sigma0us/radar-synth/README.md

# radar-synth
Dual PLL radar transmitter, design for prototyping
