sigma0us/radar-synth/hardware/output/lmx2572evm-ass/radar-synth-B_Fab.pdf

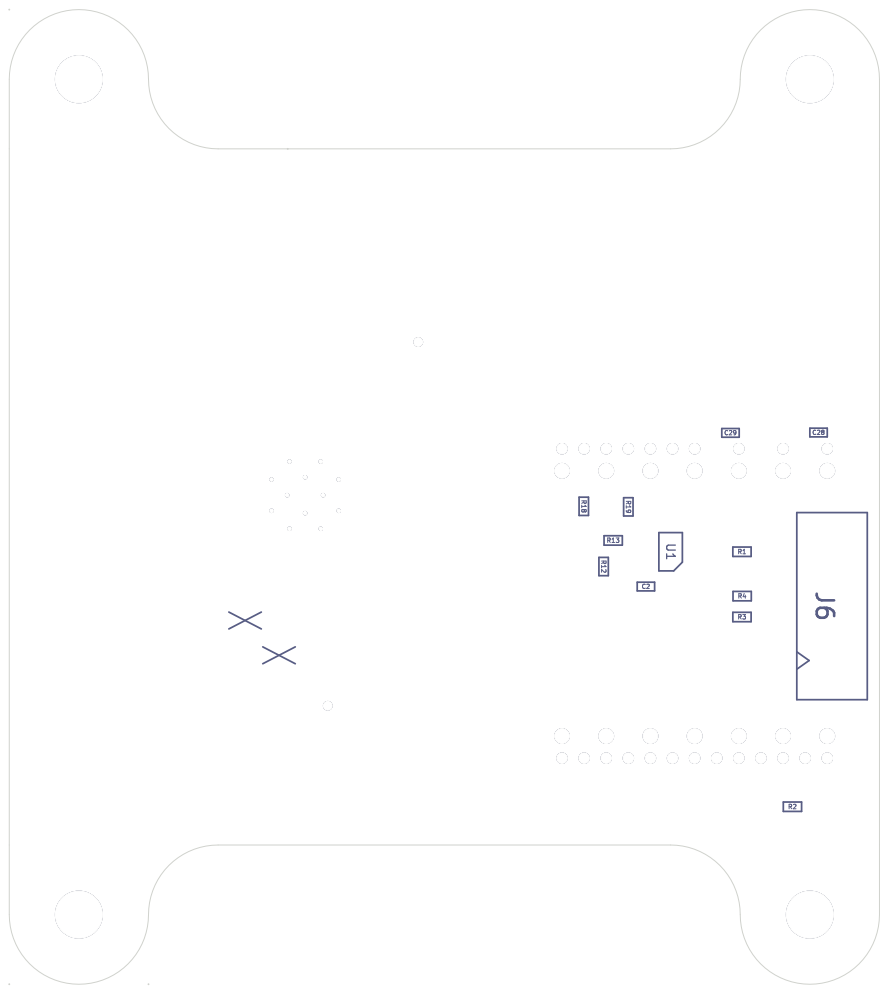
[picture p1: page 1]

Id: 1/1 Title: File: radar-synth.kicad_pcb Sheet:
