sigma0us/radar-synth/hardware/output/lmx2572evm-ass/radar-synth-F_Fab.pdf

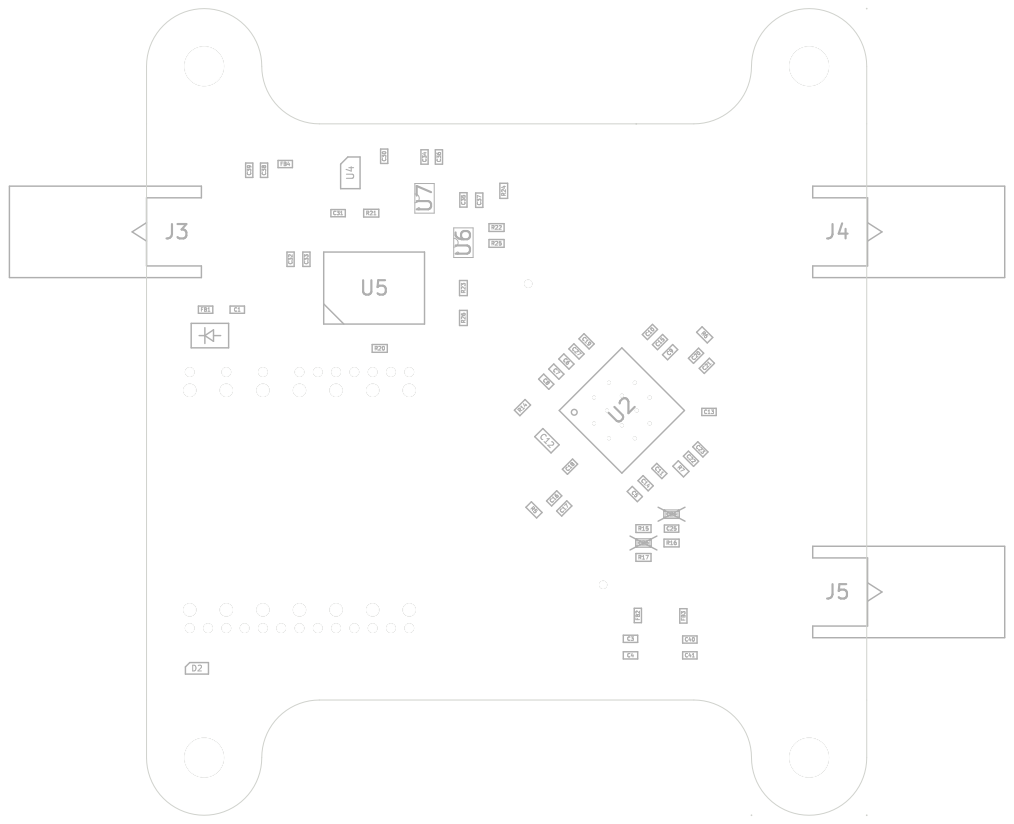
[picture p2: page 1]
