sigma0us/radar-synth/hardware/radar-synth.kicad_pcb

## KiCad design hardware/radar-synth.kicad_pcb (2025-03-31)

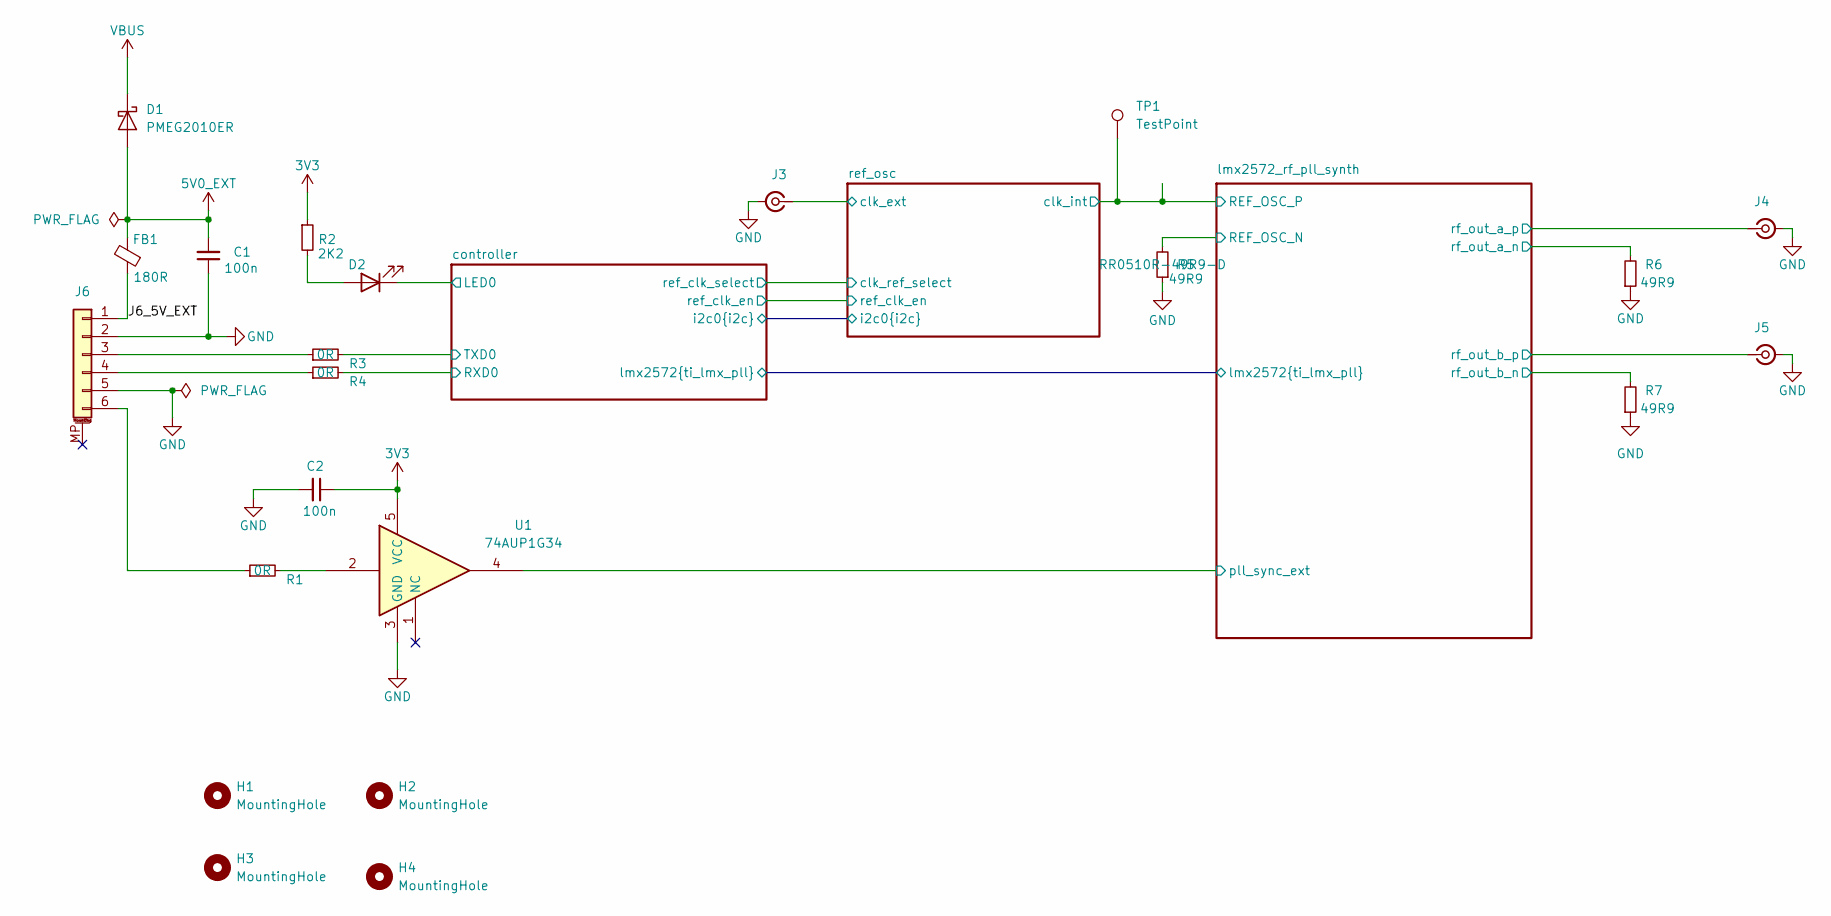
[picture p3: schematic radar-synth.kicad_sch, TOP LEVEL]

Parts:
C1, C2: 100n; C_0402_1005Metric; Voltage 25V; Tolerance 10%; MPN CL05B104KA5NNNC
D1: PMEG2010ER; Nexperia_CFP3_SOD-123W; MPN PMEG2010ER,115
D2: LED; LED_0603_1608Metric; MPN 150060SS75000
FB1: 180R; L_0402_1005Metric; MPN BLM15PX181SZ1D
H1, H2, H3, H4: MountingHole; MountingHole_2.7mm_M2.5
J3, J4, J5: Conn_Coaxial_Small; SMA_Samtec_SMA-J-P-H-ST-EM1_EdgeMount; MPN SMA-J-P-H-ST-EM1
J6: Conn_01x06_MountingPin; JST_GH_SM06B-GHS-TB_1x06-1MP_P1.25mm_Horizontal; MPN SM06B-GHS-TB
R1, R3, R4: 0R; R_0402_1005Metric; MPN ERJ-2GE0R00X
R2: 2K2; R_0402_1005Metric; MPN ERA-2AED222X
R5: 49R9; R_0402_1005Metric; Tolerance 5%; MPN RR0510R-49R9-D
R6, R7: 49R9; R_0402_1005Metric; MPN RR0510R-49R9-D
TP1: TestPoint; TestPoint_THTPad_1.0x1.0mm_Drill0.5mm
U1: 74AUP1G34; SOT-353_SC-70-5; MPN 74AUP1G34SE-7

Connections:
3V3: C2.1, R2.1, U1.5 (VCC); also elsewhere on the board
5V0_EXT: C1.2, D1.2 (A), FB1.2
/J6_5V_EXT: FB1.1, J6.1
/controller/LED0: D2.1 (K); also elsewhere on the board
/controller/RXD0: R4.2; also elsewhere on the board
/controller/TXD0: R3.2; also elsewhere on the board
/lmx2572_rf_pll_synth/REF_OSC_N: R5.2; also elsewhere on the board
/lmx2572_rf_pll_synth/REF_OSC_P: TP1.1; also elsewhere on the board
/lmx2572_rf_pll_synth/pll_sync_ext: U1.4; also elsewhere on the board
/lmx2572_rf_pll_synth/rf_out_a_n: R6.2; also elsewhere on the board
/lmx2572_rf_pll_synth/rf_out_a_p: J4.1 (In); also elsewhere on the board
/lmx2572_rf_pll_synth/rf_out_b_n: R7.2; also elsewhere on the board
/lmx2572_rf_pll_synth/rf_out_b_p: J5.1 (In); also elsewhere on the board
/ref_osc/clk_ext: J3.1 (In); also elsewhere on the board
GND: C1.1, C2.2, J3.2 (Ext), J4.2 (Ext), J5.2 (Ext), J6.2, J6.5, R5.1, R6.1, R7.1, U1.3 (GND); also elsewhere on the board
unnamed: D2.2 (A), R2.2
unnamed: J6.3, R3.1
unnamed: J6.4, R4.1
unnamed: J6.6, R1.1
unnamed: R1.2, U1.2
VBUS: D1.1 (K); also elsewhere on the board

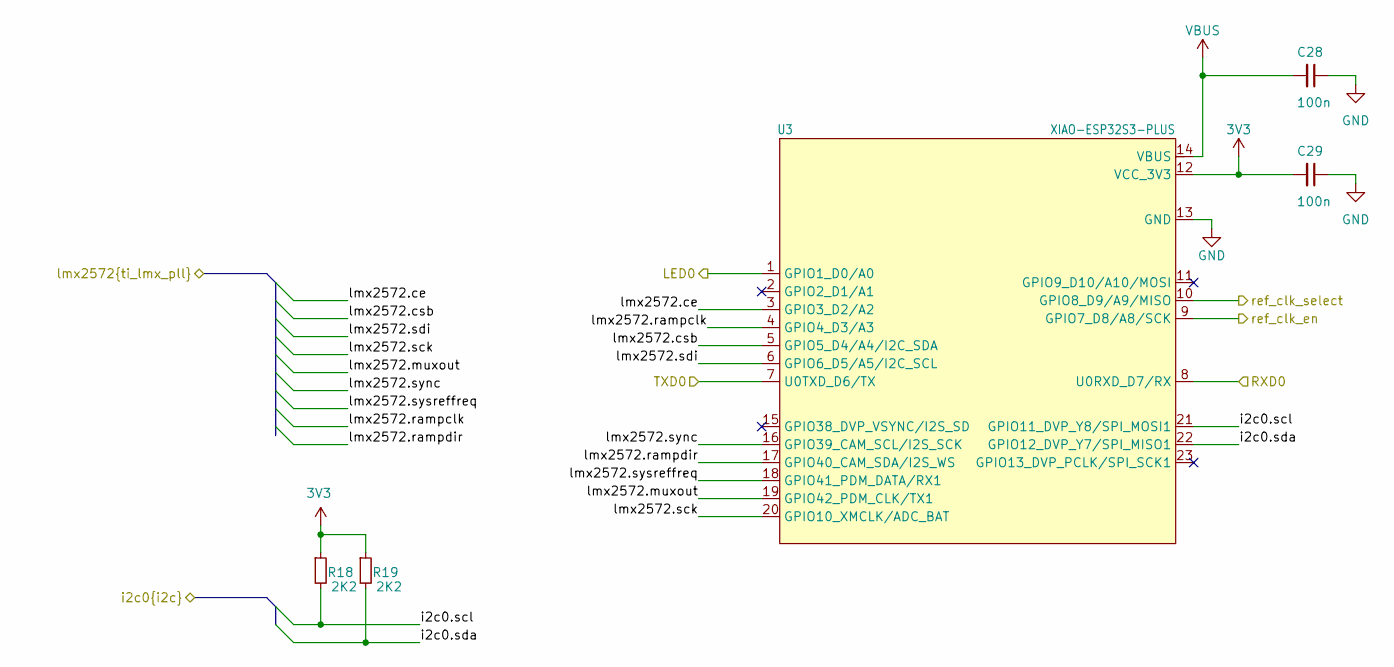
[picture p4: schematic xia0_esp32s3p_controller.kicad_sch, ESP32S3 PLUS MICROCONTROLLER]

Parts:
C28, C29: 100n; C_0402_1005Metric; Voltage 25V; Tolerance 10%; MPN CL05B104KA5NNNC
R18, R19: 2K2; R_0402_1005Metric; MPN ERA-2AED222X
U3: XIAO-ESP32S3-PLUS; XIAO-ESP32S3P-SMD-2.54-21X17.8MM; MPN 113991114

Connections:
3V3: C29.2, R18.1, R19.1, U3.12 (VCC_3V3); also elsewhere on the board
/controller/LED0: U3.1 (GPIO1_D0/A0); also elsewhere on the board
/controller/RXD0: U3.8 (U0RXD_D7/RX); also elsewhere on the board
/controller/TXD0: U3.7 (U0TXD_D6/TX); also elsewhere on the board
/controller/i2c0.scl: R18.2, U3.21 (GPIO11_DVP_Y8/SPI_MOSI1); also elsewhere on the board
/controller/i2c0.sda: R19.2, U3.22 (GPIO12_DVP_Y7/SPI_MISO1); also elsewhere on the board
/controller/lmx2572.ce: U3.3 (GPIO3_D2/A2); also elsewhere on the board
/controller/lmx2572.csb: U3.5 (GPIO5_D4/A4/I2C_SDA); also elsewhere on the board
/controller/lmx2572.muxout: U3.19 (GPIO42_PDM_CLK/TX1); also elsewhere on the board
/controller/lmx2572.rampclk: U3.4 (GPIO4_D3/A3); also elsewhere on the board
/controller/lmx2572.rampdir: U3.17 (GPIO40_CAM_SDA/I2S_WS); also elsewhere on the board
/controller/lmx2572.sck: U3.20 (GPIO10_XMCLK/ADC_BAT); also elsewhere on the board
/controller/lmx2572.sdi: U3.6 (GPIO6_D5/A5/I2C_SCL); also elsewhere on the board
/controller/lmx2572.sync: U3.16 (GPIO39_CAM_SCL/I2S_SCK); also elsewhere on the board
/controller/lmx2572.sysreffreq: U3.18 (GPIO41_PDM_DATA/RX1); also elsewhere on the board
/controller/ref_clk_en: U3.9 (GPIO7_D8/A8/SCK); also elsewhere on the board
/controller/ref_clk_select: U3.10 (GPIO8_D9/A9/MISO); also elsewhere on the board
GND: C28.1, C29.1, U3.13 (GND); also elsewhere on the board
VBUS: C28.2, U3.14 (VBUS); also elsewhere on the board

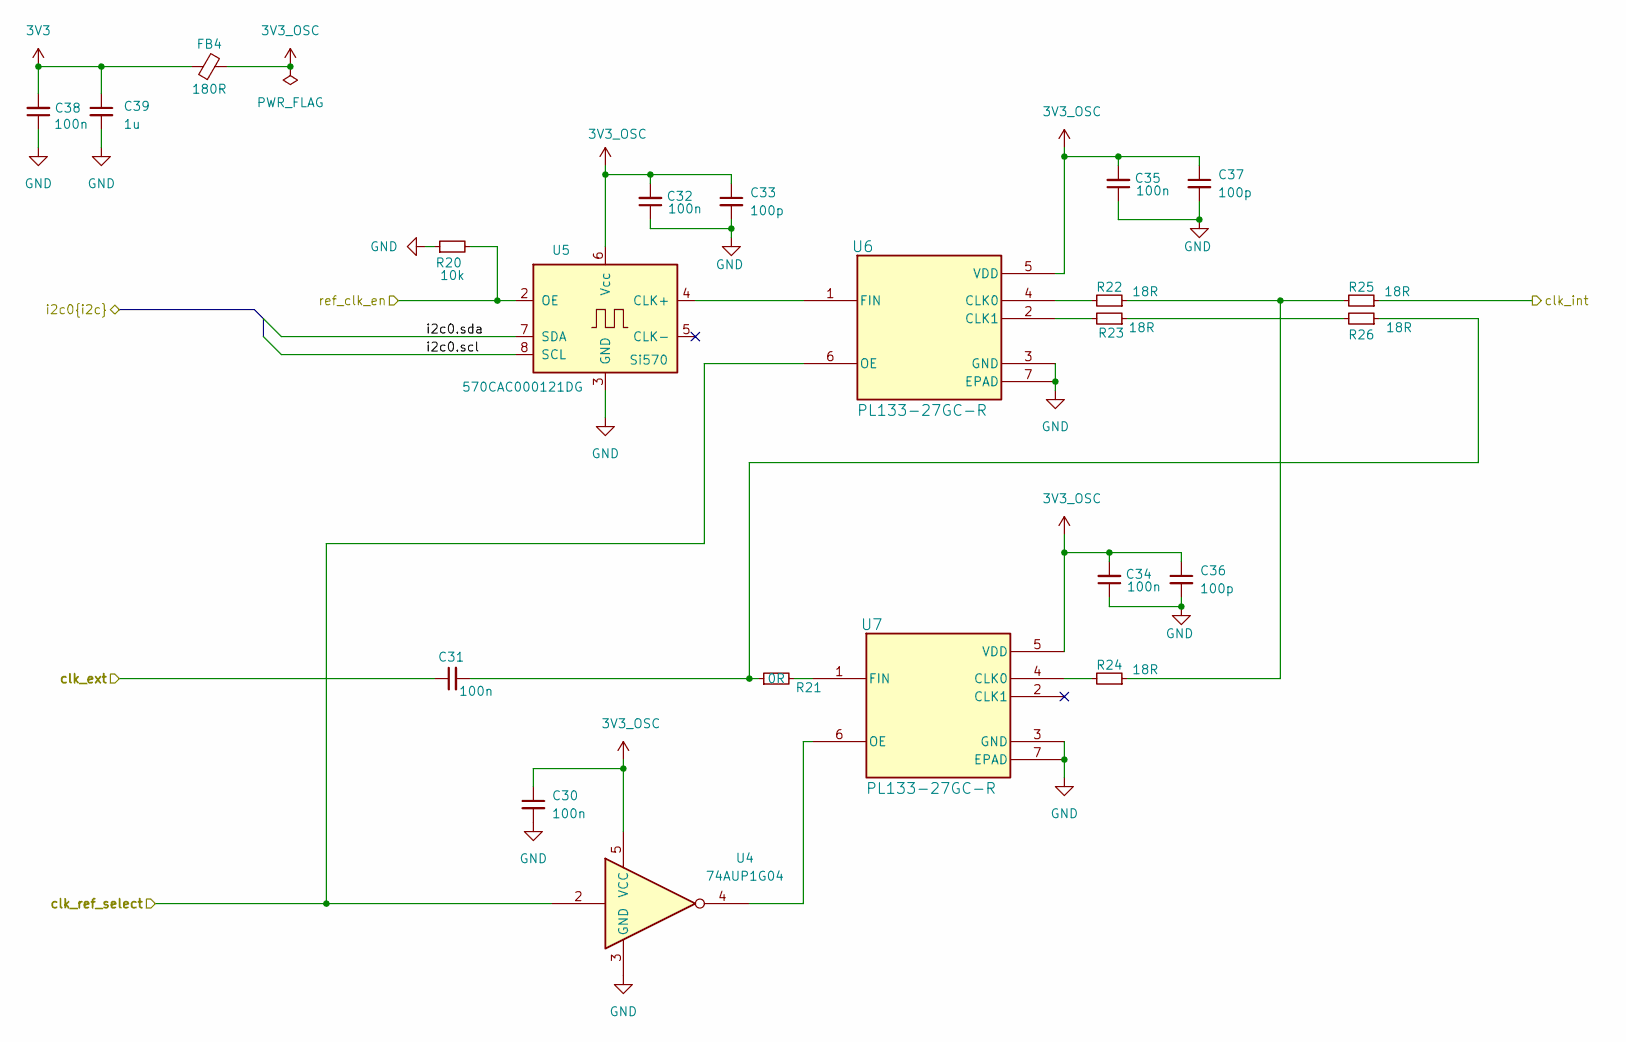
[picture p5: schematic reference_clock.kicad_sch, REFERENCE OSCILLATOR]

Parts:
C30: 100n; C_0402_1005Metric; MPN CL05B104KA5NNNC
C31, C32, C34, C35, C38: 100n; C_0402_1005Metric; Voltage 25V; Tolerance 10%; MPN CL05B104KA5NNNC
C33, C36, C37: 100p; C_0402_1005Metric; MPN KGM05AR71H101KN
C39: 1u; C_0402_1005Metric; Voltage 16V; Tolerance 10%; MPN EMK105BJ105KV-F
FB4: 180R; L_0402_1005Metric; MPN BLM15PX181SZ1D
R20: 10k; R_0402_1005Metric; MPN RC0402JR-0710KL
R21: 0R; R_0402_1005Metric; MPN ERJ-2GE0R00X
R22, R23, R24, R25, R26: 18R; R_0402_1005Metric; MPN CR0402-FX-18R0GLF
U4: 74AUP1G04; SOT-353_SC-70-5; MPN SN74AUP1G04DCKR
U5: Si570; Oscillator_SMD_SI570_SI571_Standard; MPN 570CAC000121DG
U6, U7: PL133-27GC-R; TDFN2013-6LD-PL-1_MCH; MPN PL133-27GC-R

Connections:
3V3: C38.2, C39.1, FB4.1; also elsewhere on the board
3V3_OSC: C30.1, C32.2, C33.1, C34.2, C35.2, C36.1, C37.1, FB4.2, U4.5 (VCC), U5.6 (Vcc), U6.5 (VDD), U7.5 (VDD)
/controller/i2c0.scl: U5.8 (SCL); also elsewhere on the board
/controller/i2c0.sda: U5.7 (SDA); also elsewhere on the board
/controller/ref_clk_en: R20.2, U5.2 (OE); also elsewhere on the board
/controller/ref_clk_select: U4.2, U6.6 (OE); also elsewhere on the board
/lmx2572_rf_pll_synth/REF_OSC_P: R25.1; also elsewhere on the board
/ref_osc/clk_ext: C31.1; also elsewhere on the board
GND: C30.2, C32.1, C33.2, C34.1, C35.1, C36.2, C37.2, C38.1, C39.2, R20.1, U4.3 (GND), U5.3 (GND), U6.3 (GND), U6.7 (EPAD), U7.3 (GND), U7.7 (EPAD); also elsewhere on the board
unnamed: C31.2, R21.1, R26.1
unnamed: R22.1, R24.1, R25.2
unnamed: R23.1, R26.2
unnamed: U5.4 (CLK+), U6.1 (FIN)
unnamed: R22.2, U6.4 (CLK0)
unnamed: R23.2, U6.2 (CLK1)
unnamed: R24.2, U7.4 (CLK0)
unnamed: R21.2, U7.1 (FIN)
unnamed: U4.4, U7.6 (OE)

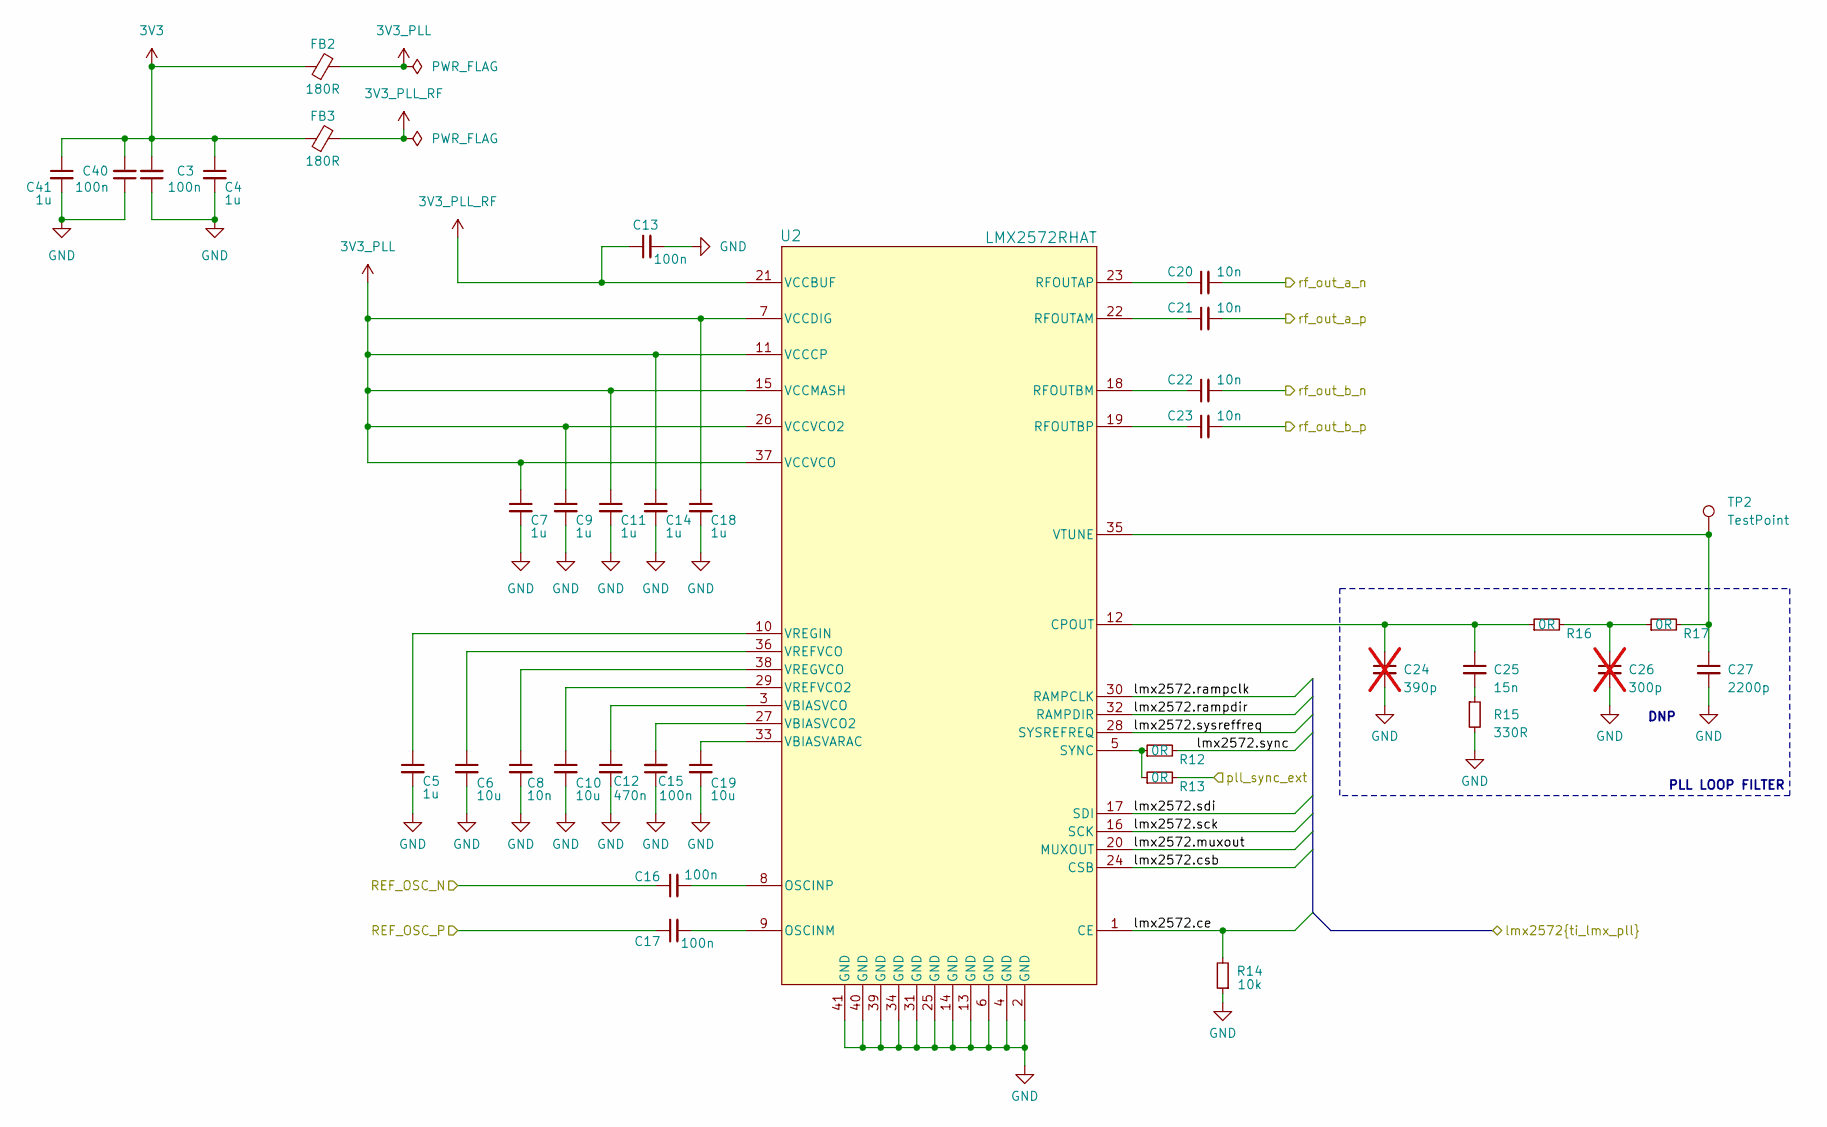
[picture p6: schematic lmx2572_rf_pll.kicad_sch, LMX2572 RF SYNTHESIZER]

Parts:
C3, C13, C15, C16, C17, C40: 100n; C_0402_1005Metric; Voltage 25V; Tolerance 10%; MPN CL05B104KA5NNNC
C4, C5, C7, C9, C11, C14, C18, C41: 1u; C_0402_1005Metric; Voltage 16V; Tolerance 10%; MPN EMK105BJ105KV-F
C6, C10, C19: 10u; C_0402_1005Metric; Voltage 10v; Tolerance 20%; MPN GRM155R61A106ME11D
C8, C20, C21, C22, C23: 10n; C_0402_1005Metric; Voltage 16V; Tolerance 10%; MPN 520L103KT16T
C12: 470n; C_0603_1608Metric; Voltage 25V; Tolerance 10%; MPN MBAST168SB7474KTNA18
C24: 390p; C_0402_1005Metric; MPN GRM1555C1H391JA01D; not fitted
C25: 15n; C_0402_1005Metric; MPN C0402C153J4RACTU
C26: 300p; C_0402_1005Metric; MPN GRM1555C1H301JA01D; not fitted
C27: 2200p; C_0402_1005Metric; MPN VJ0402Y222JXXAC
FB2, FB3: 180R; L_0402_1005Metric; MPN BLM15PX181SZ1D
R12, R13, R16, R17: 0R; R_0402_1005Metric; MPN ERJ-2GE0R00X
R14: 10k; R_0402_1005Metric; MPN RC0402JR-0710KL
R15: 330R; R_0402_1005Metric; MPN RC0402JR-07330RL
TP2: TestPoint; TestPoint_THTPad_1.0x1.0mm_Drill0.5mm
U2: LMX2572RHAT; RHA0040H; MPN LMX2572RHAT

Connections:
3V3: C3.2, C4.1, C40.2, C41.1, FB2.1, FB3.1; also elsewhere on the board
3V3_PLL: C7.1, C9.1, C11.1, C14.1, C18.1, FB2.2, U2.7 (VCCDIG), U2.11 (VCCCP), U2.15 (VCCMASH), U2.26 (VCCVCO2), U2.37 (VCCVCO)
3V3_PLL_RF: C13.1, FB3.2, U2.21 (VCCBUF)
/controller/lmx2572.ce: R14.2, U2.1 (CE); also elsewhere on the board
/controller/lmx2572.csb: U2.24 (CSB); also elsewhere on the board
/controller/lmx2572.muxout: U2.20 (MUXOUT); also elsewhere on the board
/controller/lmx2572.rampclk: U2.30 (RAMPCLK); also elsewhere on the board
/controller/lmx2572.rampdir: U2.32 (RAMPDIR); also elsewhere on the board
/controller/lmx2572.sck: U2.16 (SCK); also elsewhere on the board
/controller/lmx2572.sdi: U2.17 (SDI); also elsewhere on the board
/controller/lmx2572.sync: R12.2; also elsewhere on the board
/controller/lmx2572.sysreffreq: U2.28 (SYSREFREQ); also elsewhere on the board
/lmx2572_rf_pll_synth/REF_OSC_N: C16.1; also elsewhere on the board
/lmx2572_rf_pll_synth/REF_OSC_P: C17.1; also elsewhere on the board
/lmx2572_rf_pll_synth/pll_sync_ext: R13.2; also elsewhere on the board
/lmx2572_rf_pll_synth/rf_out_a_n: C20.2; also elsewhere on the board
/lmx2572_rf_pll_synth/rf_out_a_p: C21.2; also elsewhere on the board
/lmx2572_rf_pll_synth/rf_out_b_n: C22.2; also elsewhere on the board
/lmx2572_rf_pll_synth/rf_out_b_p: C23.2; also elsewhere on the board
GND: C3.1, C4.2, C5.2, C6.2, C7.2, C8.2, C9.2, C10.2, C11.2, C12.2, C13.2, C14.2, C15.1, C18.2, C19.2, C24.2, C26.2, C27.2, C40.1, C41.2, R14.1, R15.2, U2.2 (GND), U2.4 (GND), U2.6 (GND), U2.13 (GND), U2.14 (GND), U2.25 (GND), U2.31 (GND), U2.34 (GND), U2.39 (GND), U2.40 (GND), U2.41 (GND), U2.V; also elsewhere on the board
unnamed: C25.2, R15.1
unnamed: C26.1, R16.2, R17.1
unnamed: C24.1, C25.1, R16.1, U2.12 (CPOUT)
unnamed: C17.2, U2.9 (OSCINM)
unnamed: C16.2, U2.8 (OSCINP)
unnamed: C21.1, U2.22 (RFOUTAM)
unnamed: C20.1, U2.23 (RFOUTAP)
unnamed: C22.1, U2.18 (RFOUTBM)
unnamed: C23.1, U2.19 (RFOUTBP)
unnamed: R12.1, R13.1, U2.5 (SYNC)
unnamed: C19.1, U2.33 (VBIASVARAC)
unnamed: C15.2, U2.27 (VBIASVCO2)
unnamed: C12.1, U2.3 (VBIASVCO)
unnamed: C10.1, U2.29 (VREFVCO2)
unnamed: C6.1, U2.36 (VREFVCO)
unnamed: C5.1, U2.10 (VREGIN)
unnamed: C8.1, U2.38 (VREGVCO)
unnamed: C27.1, R17.2, TP2.1, U2.35 (VTUNE)

Notes on the sheet:
DNP
PLL LOOP FILTER

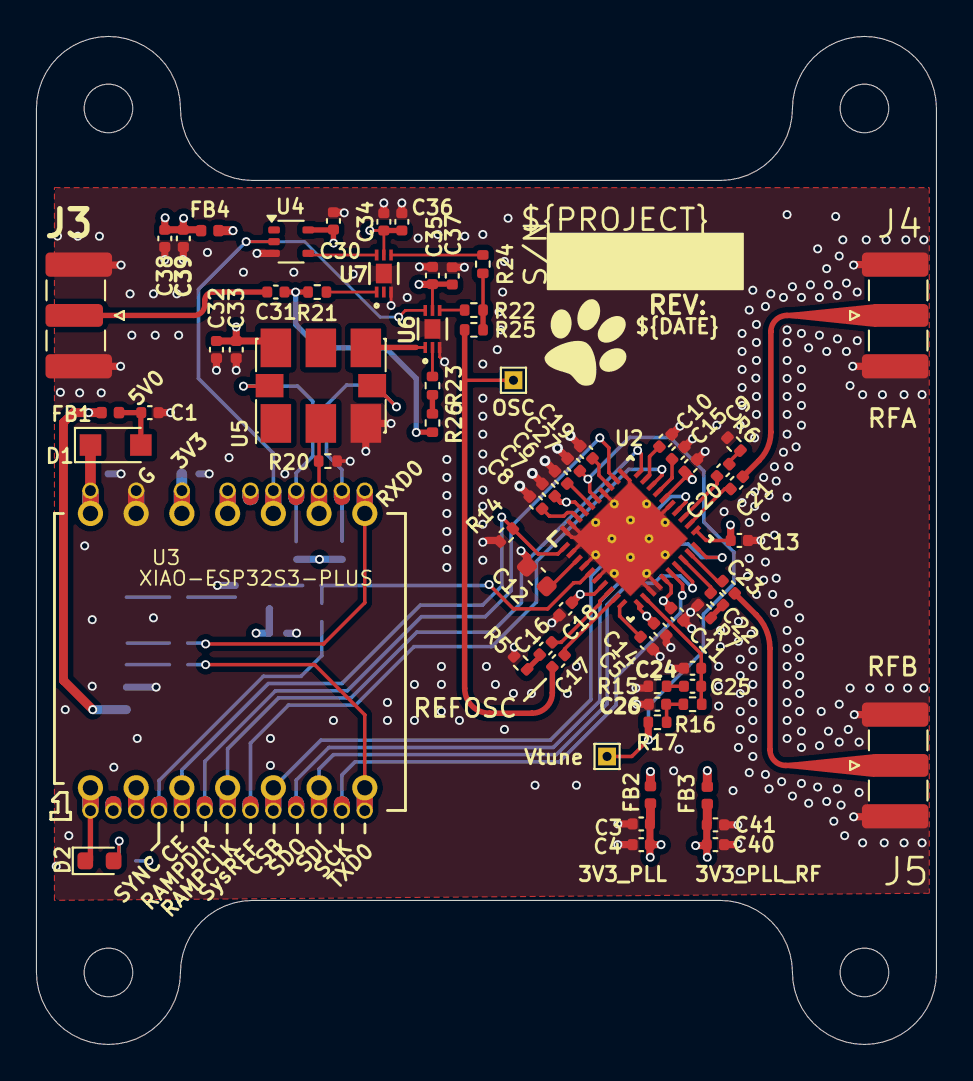
[picture p7: board radar-synth.kicad_pcb from above]

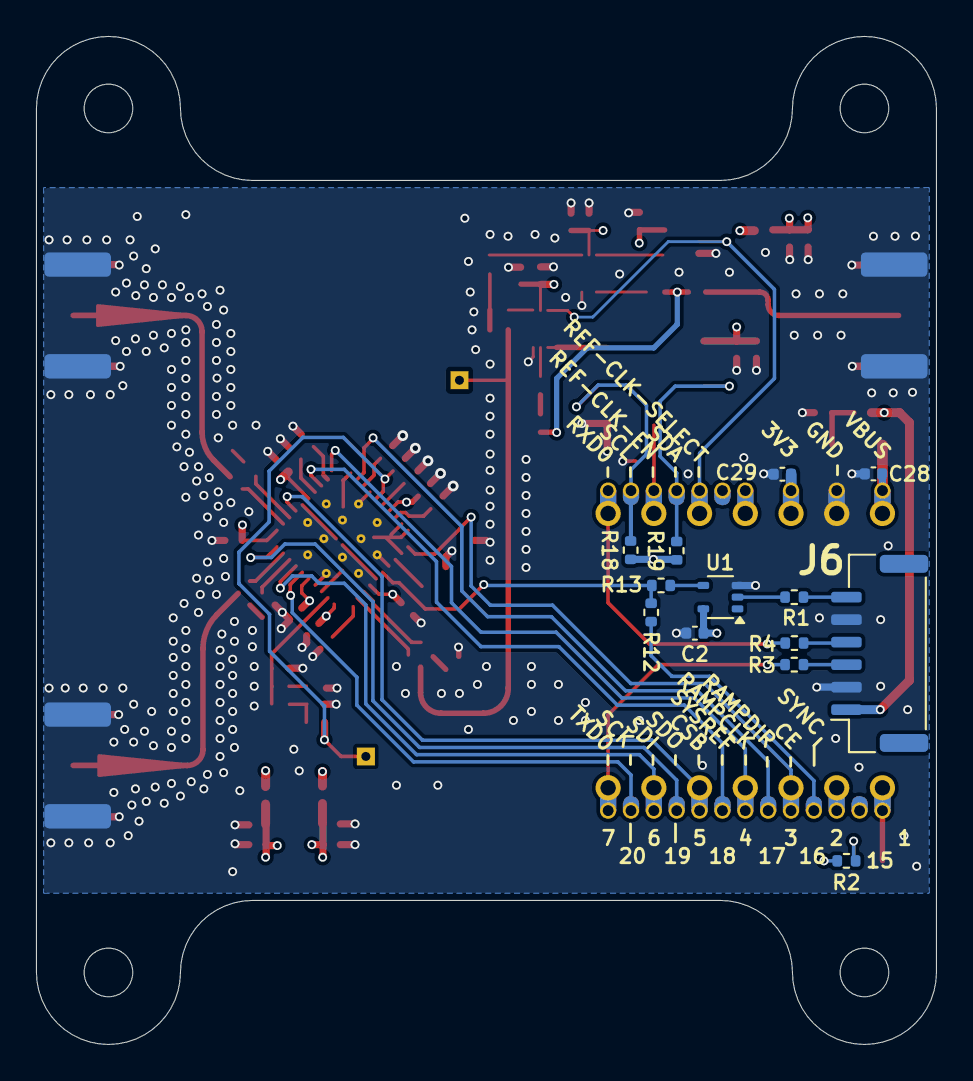
[picture p8: board radar-synth.kicad_pcb from below]

Board: 4 copper layers, 50.0 x 56.0 mm, 86 parts (13 on the bottom side), 64 nets.
