sigma0us/radar-synth/(commit log)

2024-12-30 Initial release
    [lmx2572_rf_pll.kicad_sch, radar-synth.kicad_pcb, radar-synth.kicad_sch]
2025-03-28 Completed schematics
    [lmx2572_rf_pll.kicad_sch, radar-synth.kicad_sch, reference_clock.kicad_sch, xia0_esp32s3p_controller.kicad_sch]
2025-03-30 Completed core PCB routing
    [lmx2572_rf_pll.kicad_sch, radar-synth.kicad_pcb, radar-synth.kicad_sch, reference_clock.kicad_sch, xia0_esp32s3p_controller.kicad_sch]
2025-03-30 Ready for FAB info
    [lmx2572_rf_pll.kicad_sch, radar-synth.kicad_pcb, radar-synth.kicad_sch, reference_clock.kicad_sch, xia0_esp32s3p_controller.kicad_sch]
2025-03-31 Sent off for quote
    [lmx2572_rf_pll.kicad_sch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]
2025-03-31 Fixed silkscreen and re-submitted
    [radar-synth.kicad_pcb]
2025-05-26 Updated firmware
    [lmx2572_rf_pll.kicad_sch, radar-synth.kicad_sch, test.kicad_pcb, test.kicad_sch]
